Ben-coderr/robot-car/docs/pdf/Shopping_List_Robot_Car.pdf

# Everything to buy for one car

### A · Main parts

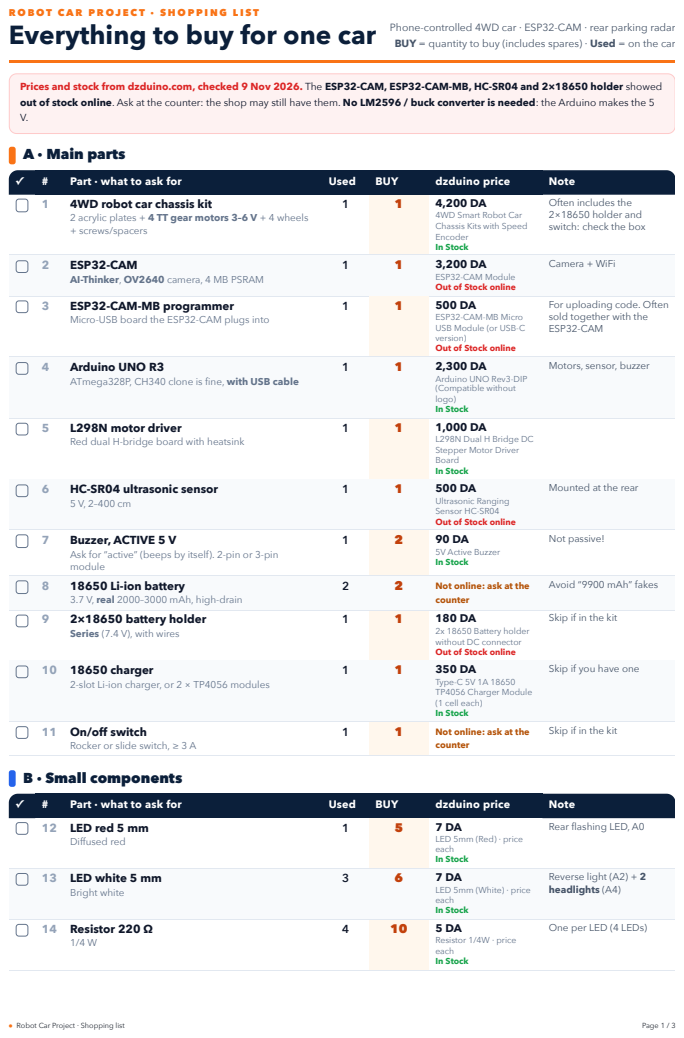
[picture p73: page 1]
Part · what to ask for; Used; BUY; dzduino price; Note; Camera + WiFi; 5V Active Buzzer In Stock; Not passive!; Not online: ask at the; counter; Type-C 5V 1A 18650 TP4056 Charger Module (1 cell each) In Stock; Reverse light (A2) + 2 headlights (A4); 14 Resistor 220 Ω 1/4 W; Resistor 1/4W · price each In Stock; ● Robot Car Project · Shopping list; Page 1 / 3

Phone-controlled 4WD car · ESP32-CAM · rear parking radar
BUY = quantity to buy (includes spares) · Used = on the car

Prices and stock from dzduino.com, checked 9 Nov 2026. The ESP32-CAM, ESP32-CAM-MB, HC-SR04 and 2×18650 holder showed
out of stock online. Ask at the counter: the shop may still have them. No LM2596 / buck converter is needed: the Arduino makes the 5

1 4WD robot car chassis kit
2 acrylic plates + 4 TT gear motors 3–6 V + 4 wheels
+ screws/spacers

Often includes the
2×18650 holder and
switch: check the box

4WD Smart Robot Car
Chassis Kits with Speed
Encoder
In Stock

2 ESP32-CAM
AI-Thinker, OV2640 camera, 4 MB PSRAM
3 ESP32-CAM-MB programmer
Micro-USB board the ESP32-CAM plugs into

ESP32-CAM Module
Out of Stock online

For uploading code. Often
sold together with the
ESP32-CAM

ESP32-CAM-MB Micro
USB Module (or USB-C
version)

4 Arduino UNO R3
ATmega328P, CH340 clone is fine, with USB cable

Motors, sensor, buzzer

Arduino UNO Rev3-DIP
(Compatible without
logo)

5 L298N motor driver
Red dual H-bridge board with heatsink

L298N Dual H Bridge DC
Stepper Motor Driver
Board

6 HC-SR04 ultrasonic sensor

Mounted at the rear

Ultrasonic Ranging
Sensor HC-SR04

7 Buzzer, ACTIVE 5 V
Ask for “active” (beeps by itself). 2-pin or 3-pin
module
8 18650 Li-ion battery
3.7 V, real 2000–3000 mAh, high-drain
9 2×18650 battery holder
Series (7.4 V), with wires

Avoid “9900 mAh” fakes

Skip if in the kit

2x 18650 Battery holder
without DC connector

10 18650 charger
2-slot Li-ion charger, or 2 × TP4056 modules

Skip if you have one

11 On/off switch
Rocker or slide switch, ≥ 3 A
B · Small components

12 LED red 5 mm
Diffused red

Rear flashing LED, A0

LED 5mm (Red) · price
each

13 LED white 5 mm
Bright white

LED 5mm (White) · price

One per LED (4 LEDs)

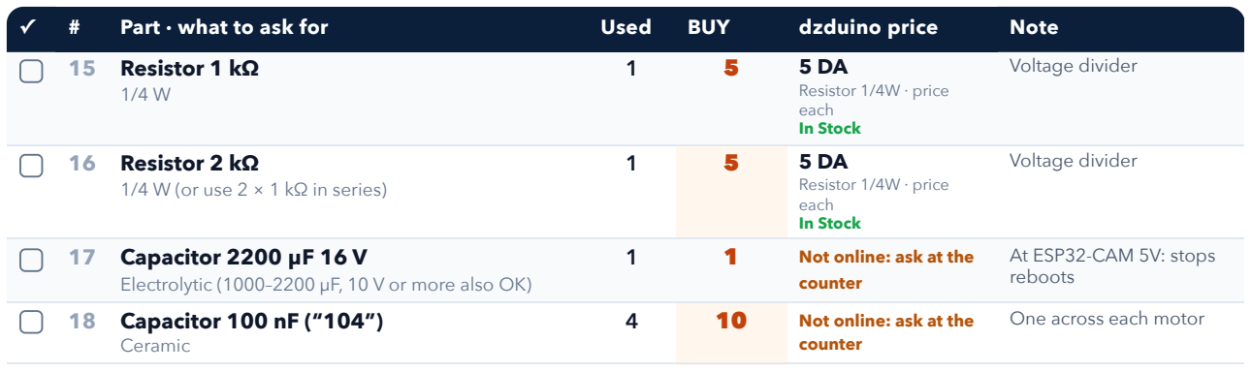
[picture p74: figure]
15 Resistor 1 kΩ 1/4 W; Resistor 1/4W · price each In Stock; Voltage divider; 16 Resistor 2 kΩ 1/4 W (or use 2 × 1 kΩ in series); 17 Capacitor 2200 µF 16 V; Not online: ask at the; counter; At ESP32-CAM 5V: stops reboots; 18 Capacitor 100 nF (“104”) Ceramic; One across each motor

✓ | # | Part · what to ask for | Used | BUY | dzduino price | Note

Electrolytic (1000–2200 µF, 10 V or more also OK)

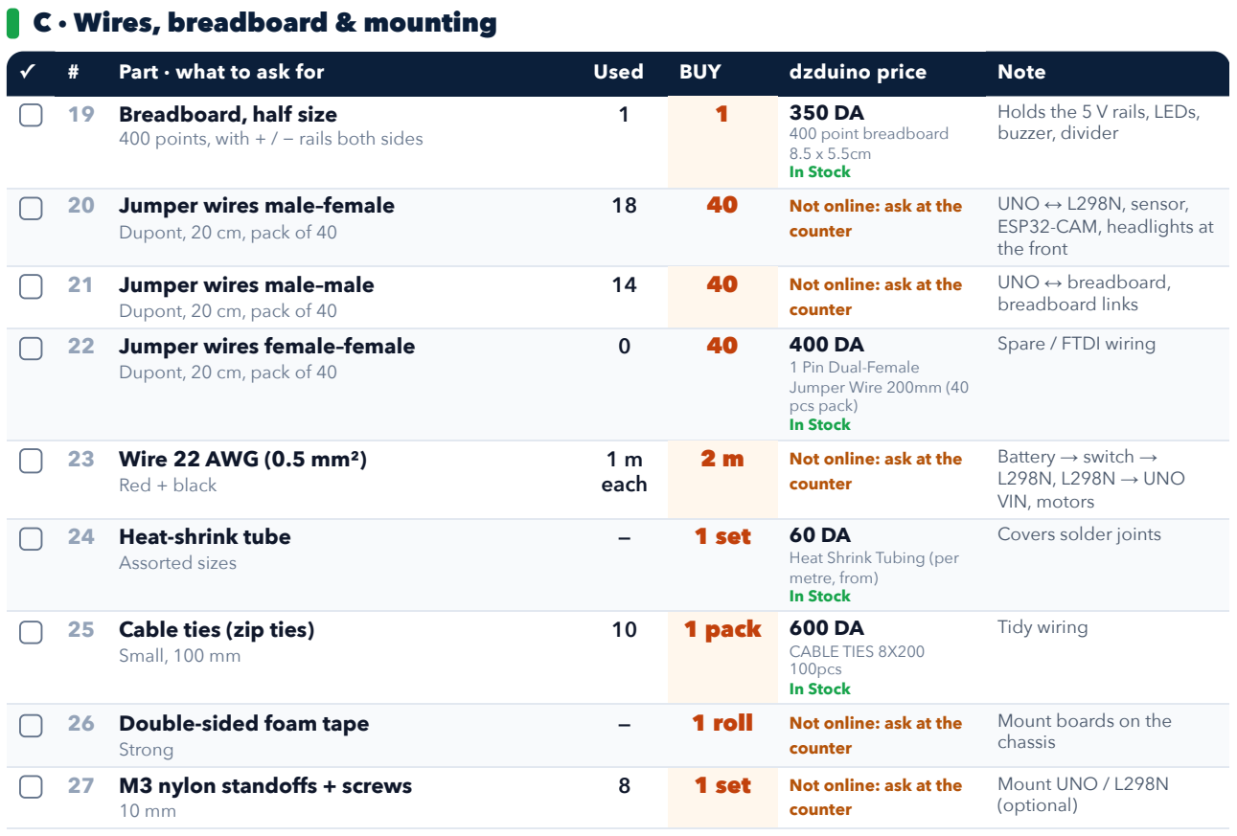
[picture p75: figure]
C · Wires, breadboard & mounting; 19 Breadboard, half size 400 points, with + / − rails both sides; 400 point breadboard 8.5 x 5.5cm In Stock; Holds the 5 V rails, LEDs, buzzer, divider; 20 Jumper wires male–female Dupont, 20 cm, pack of 40; Not online: ask at the; counter; UNO ↔ L298N, sensor, ESP32-CAM, headlights at the front; 21 Jumper wires male–male Dupont, 20 cm, pack of 40; UNO ↔ breadboard, breadboard links; 22 Jumper wires female–female Dupont, 20 cm, pack of 40; 1 Pin Dual-Female Jumper Wire 200mm (40 pcs pack) In Stock; Spare / FTDI wiring; 23 Wire 22 AWG (0.5 mm²) Red + black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

✓ | # | Part · what to ask for | Used | BUY | dzduino price | Note

### Total of the parts with an online price (A + B + C): ≈ 13,997 DA

Plus the parts not listed online: 18650 Li-ion battery, On/off switch, Capacitor 2200 µF 16 V, Capacitor 100 nF (“104”), Jumper wires male– female, Jumper wires male–male, Wire 22 AWG (0.5 mm²), Double-sided foam tape, M3 nylon standoffs + screws. Free delivery over 5000 DA.

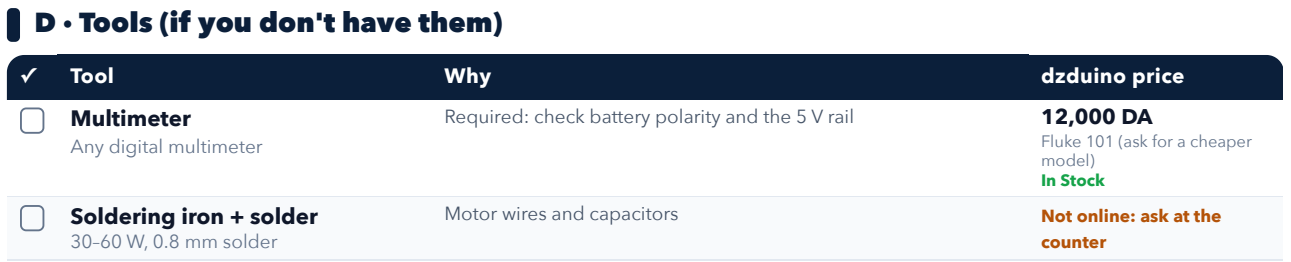
[picture p76: figure]
D · Tools (if you don't have them); Tool; Why; dzduino price; Multimeter Any digital multimeter; Fluke 101 (ask for a cheaper model) In Stock; Soldering iron + solder 30–60 W, 0.8 mm solder; Motor wires and capacitors; Not online: ask at the; counter

Required: check battery polarity and the 5 V rail | 12,000 DA

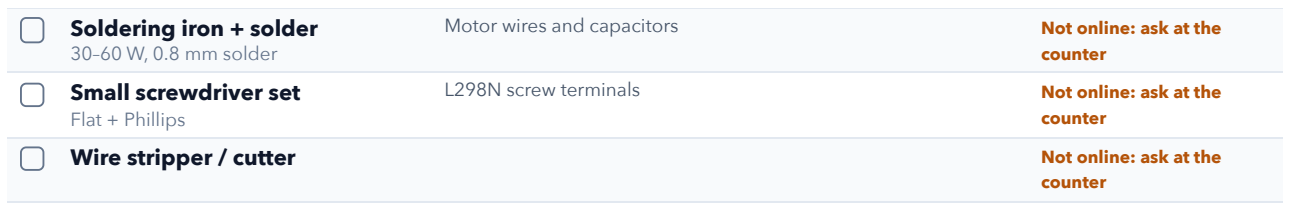
[picture p77: figure]
Small screwdriver set Flat + Phillips; L298N screw terminals; Not online: ask at the; counter; Wire stripper / cutter

- Robot Car Project · Shopping list | Page 2 / 3

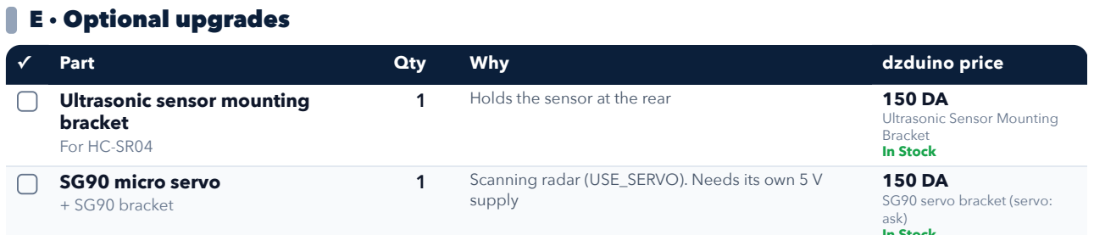
[picture p78: figure]
E · Optional upgrades; Part; Qty; Why; dzduino price; Ultrasonic sensor mounting bracket For HC-SR04; Holds the sensor at the rear; Ultrasonic Sensor Mounting Bracket In Stock; SG90 micro servo + SG90 bracket; supply; 150 DA SG90 servo bracket (servo: ask)
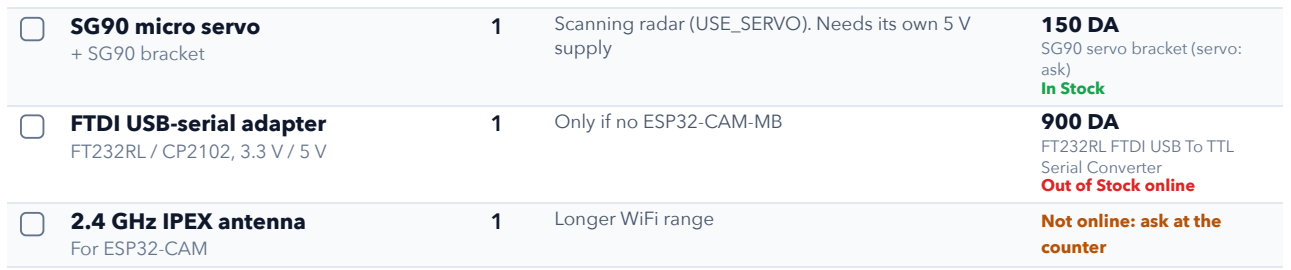
[picture p79: figure]
In Stock; FTDI USB-serial adapter FT232RL / CP2102, 3.3 V / 5 V; Only if no ESP32-CAM-MB; FT232RL FTDI USB To TTL Serial Converter Out of Stock online; 2.4 GHz IPEX antenna For ESP32-CAM; Longer WiFi range; Not online: ask at the; counter

### 1 Scanning radar (USE_SERVO). Needs its own 5 V

### Check before you pay

! Buzzer must be ACTIVE
Active = it beeps when you connect 5 V. Ask the seller to test it, or look for a sealed back with a sticker. A passive one stays silent on DC.

! ESP32-CAM: AI-Thinker + OV2640 Check the camera ribbon is in the box. Buying it together with the MB programmer board avoids the FTDI wiring.

i 18650 batteries
Real cells weigh about 45 g. Very light cells with “9900 mAh” are fake and will make the ESP32-CAM reboot.

i Chassis kit contents
If the kit already has the battery holder, switch or wires, don't buy them twice: tick them off in the list.

Why these quantities: 4 resistors 220 Ω (red LED A0, white reverse LED A2, 2 white headlights A4: one resistor each), 2200 µF at the ESP32-CAM, 1 kΩ + 2 kΩ divider (UNO D2 → ESP32 IO15), 4 × 100 nF (one per motor). About 18 male–female and 14 male–male jumpers are used; buy packs of 40 for spares. Prices on dzduino.com change: check them in the shop.

- Robot Car Project · Shopping list | Page 3 / 3
