Ben-coderr/robot-car/docs/3d/robot_car_assembly.3mf

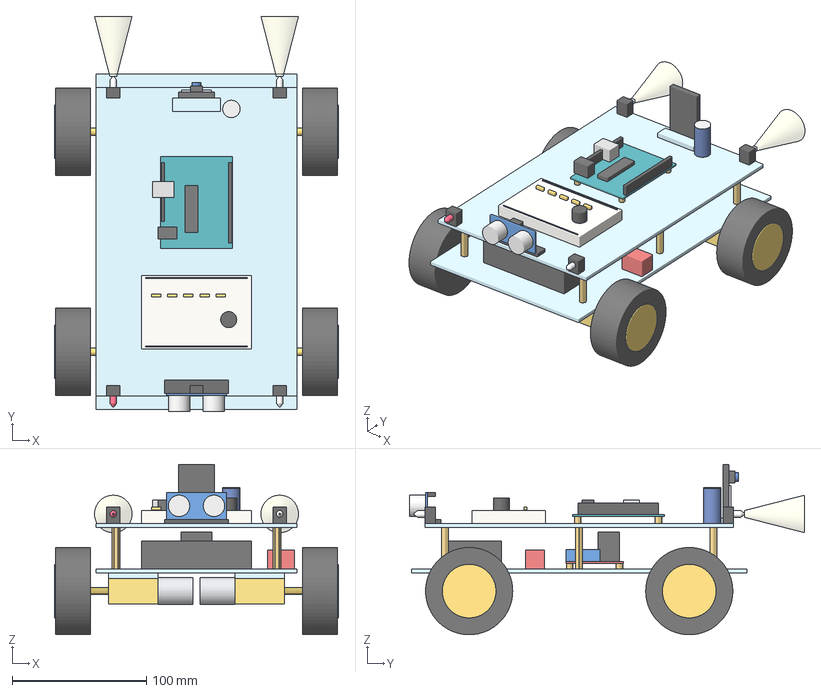
[picture p80: CAD file, 2026-11-10]
docs/3d/robot_car_assembly.3mf
211.6 x 294.6 x 127.0 mm
Bottom plate (acrylic)
Top plate (acrylic)
Spacer 1 (brass M3, 30 mm)
Spacer 2 (brass M3, 30 mm)
Spacer 3 (brass M3, 30 mm)
Spacer 4 (brass M3, 30 mm)
Spacer 5 (brass M3, 30 mm)
Spacer 6 (brass M3, 30 mm)
LEFT FRONT TT motor gearbox
LEFT FRONT wheel shaft
LEFT FRONT TT motor
LEFT FRONT motor bracket
LEFT FRONT wheel tyre (65 mm)
LEFT FRONT wheel rim
LEFT FRONT 100nF capacitor
LEFT REAR TT motor gearbox
LEFT REAR wheel shaft
LEFT REAR TT motor
LEFT REAR motor bracket
LEFT REAR wheel tyre (65 mm)
LEFT REAR wheel rim
LEFT REAR 100nF capacitor
RIGHT FRONT TT motor gearbox
RIGHT FRONT wheel shaft
RIGHT FRONT TT motor
RIGHT FRONT motor bracket
RIGHT FRONT wheel tyre (65 mm)
RIGHT FRONT wheel rim
RIGHT FRONT 100nF capacitor
RIGHT REAR TT motor gearbox
RIGHT REAR wheel shaft
RIGHT REAR TT motor
RIGHT REAR motor bracket
RIGHT REAR wheel tyre (65 mm)
RIGHT REAR wheel rim
RIGHT REAR 100nF capacitor
L298N board
L298N heatsink
L298N screw terminals
L298N standoffs
2x18650 battery holder
18650 cell (blue)
18650 cell (green)
ON/OFF switch
Arduino UNO board
UNO USB-B socket
UNO DC jack
UNO chip (ATmega328P)
UNO pin headers
UNO standoffs
Breadboard (400 points)
Breadboard + rail strip
Breadboard - rail strip
Resistor 1
Resistor 2
Resistor 3
Resistor 4
Resistor 5
Active buzzer
ESP32-CAM holder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
