Ben-coderr/robot-car/(list of files, cad)

Other CAD files:
docs/3d/robot_car_assembly.stl
