Ben-coderr/robot-car/(commit log)

2026-11-10 Initial commit: 4WD Robot Car platform with full documentation, diagrams, firmware, and web apps
    [robot_car_assembly.3mf, robot_car_assembly.stl]
2026-11-10 Add main Smart Rover banner logo and documentation hub landing page
2026-11-13 fix(esp32): stabilize power rail, add sensor fallbacks, and optimize video streaming
    - Lower Wi-Fi TX power to 15 dBm to eliminate transient current surges and brownout reset loops
    - Actively drive GPIO 4 flash LED LOW at early boot to suppress reset flicker
    - Add RGB565 double-buffering fallback for non-JPEG camera sensors (e.g., GC2145, OV7670)
    - Optimize video streaming with TCP_NODELAY and socket queue protection
    - Add melody playback (P command) and drive direction inversion relay to Arduino Uno
    [config.h, esp32cam_robot.ino]
2026-11-13 feat(audio/safety): add hardware tone generator, retro melody player, and direction-aware reverse warning
    - Implement Timer1 CTC hardware square wave tone generator on pin A3 with 375 ns naked ISR
    - Store Super Mario Bros 8-bit retro theme in PROGMEM with beat-synchronized headlights
    - Prevent timer mode teardown between notes to eliminate clicks and pops
    - Add invertReverseWarning synchronized via C config command so reverse alarm and auto-braking activate only when moving backward
    - Update docs/05_PROTOCOL.md with song playback (P command) and extended calibration parameters
    [uno_controller.ino]
2026-11-13 feat(ui): overhaul teleoperation cockpit with modern mobile-first design, dual themes, and melody player
    - Redesign web cockpit with responsive thumb-friendly layout and tactile feedback
    - Add Architectural White (Light) and Obsidian Stealth (Dark) theme engine
    - Implement interactive drive dynamics calibration (invert drive, invert steer, swap motor channels)
    - Add 8-bit retro melody player button with synchronized real-time Web Audio synthesizer
    - Embed updated assets into firmware headers via build_ui.py and update live demo portal
