Ben-coderr/robot-car/(notices)

Notices in the files:
README.md:
License: MIT
